janelia-kicad/stepper_driver/documentation/bom/wip.org

| Item | Description                     | Manufacturer Part Number | Manufacturer        |
|------+---------------------------------+--------------------------+---------------------|
|    1 | 1MM FLEX CABLE JUMPER           | FJ-20-D-12.00-4          | Samtec Inc.         |
|    2 | CONN FFC BOTTOM 20POS 1MM R/A   | ZF1-20-01-T-WT-TR        | Samtec Inc.         |
|    3 | TERM BLOCK PLUG 8POS STR 2.5MM  | 1778890                  | Phoenix Contact     |
|    5 | 1168-TGH-0075-01-ND             | TGH-0075-01              | t-Global Technology |
|      |                                 |                          |                     |
