janelia-kicad/stepper_driver/documentation/schematic/stepper_driver.pdf

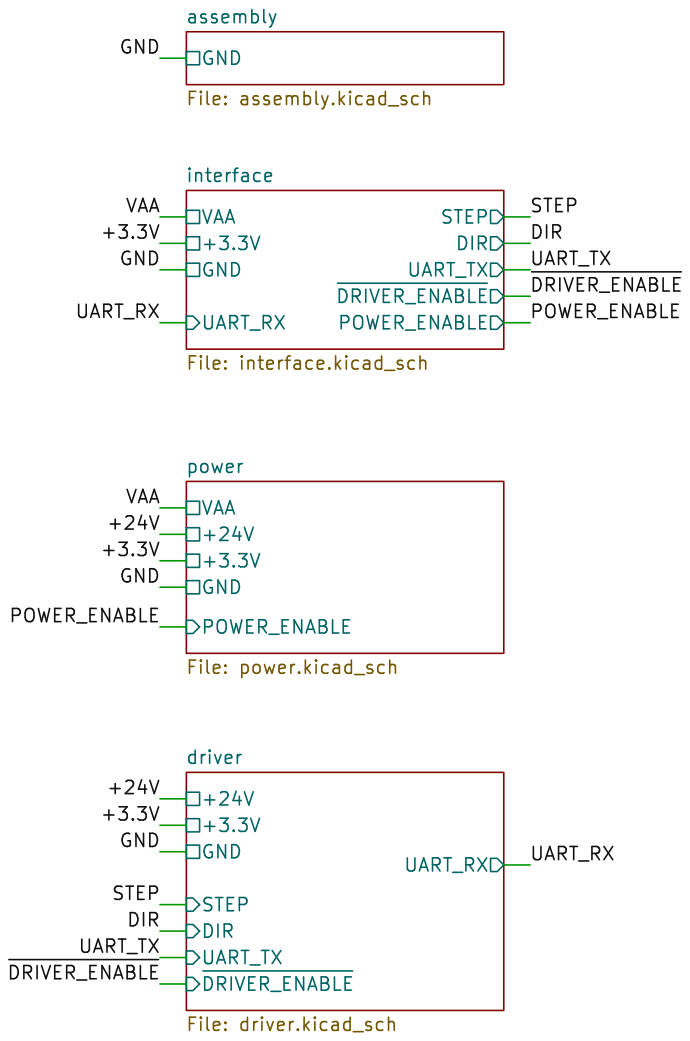
[picture p1: page 1]

assembly File: assembly.kicad_sch DIR
+24V GND GND

interface File: interface.kicad_sch GND

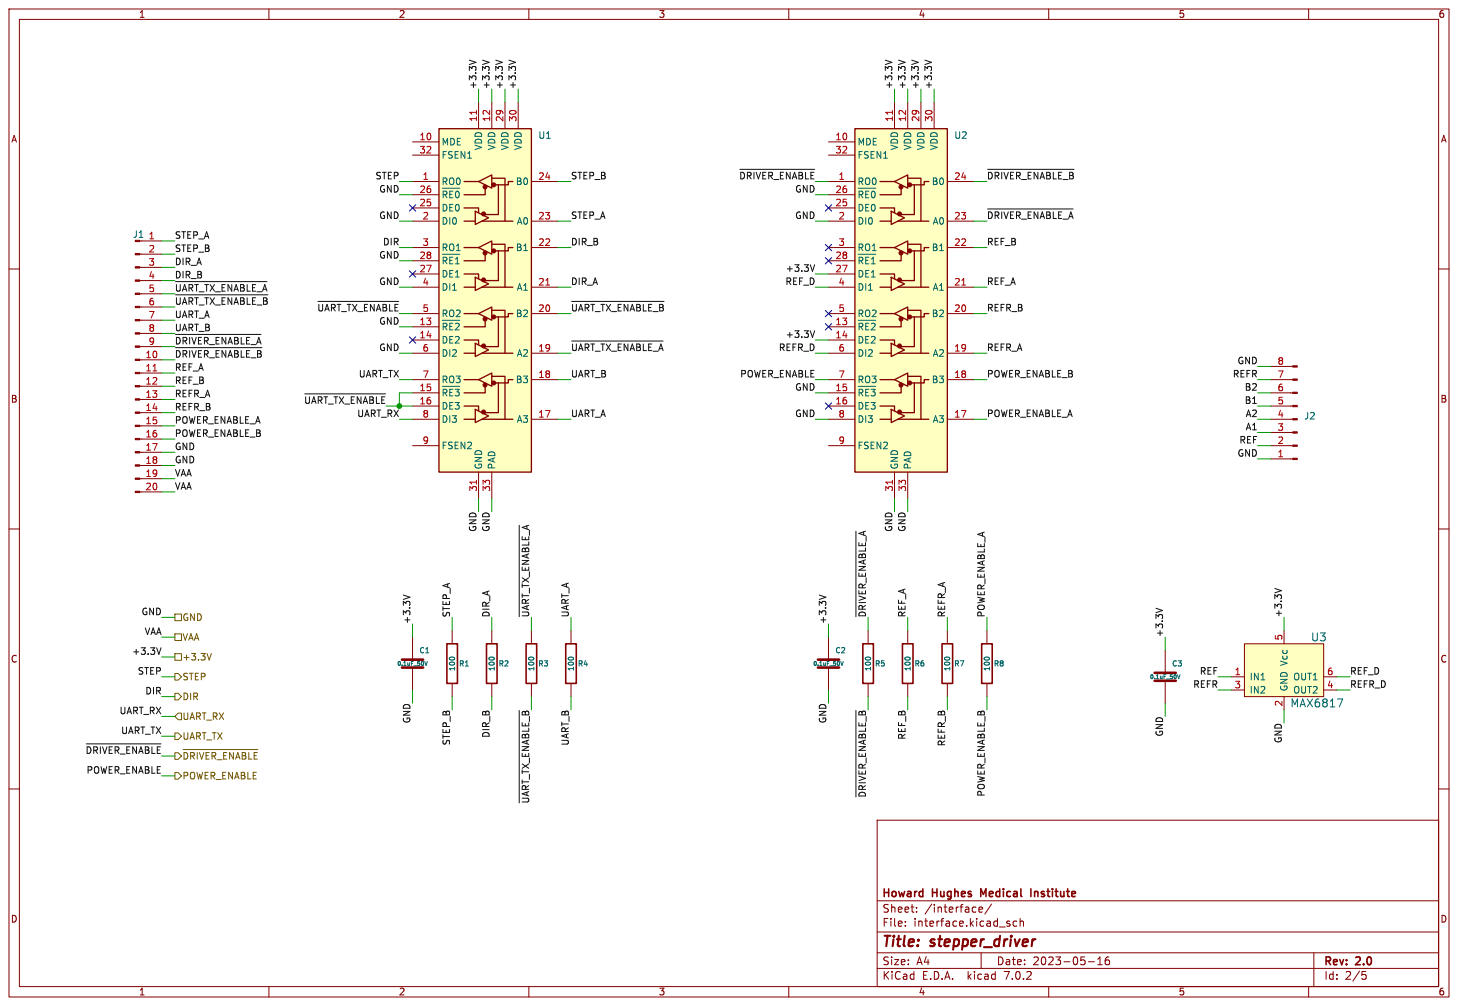
[picture p2: page 2]

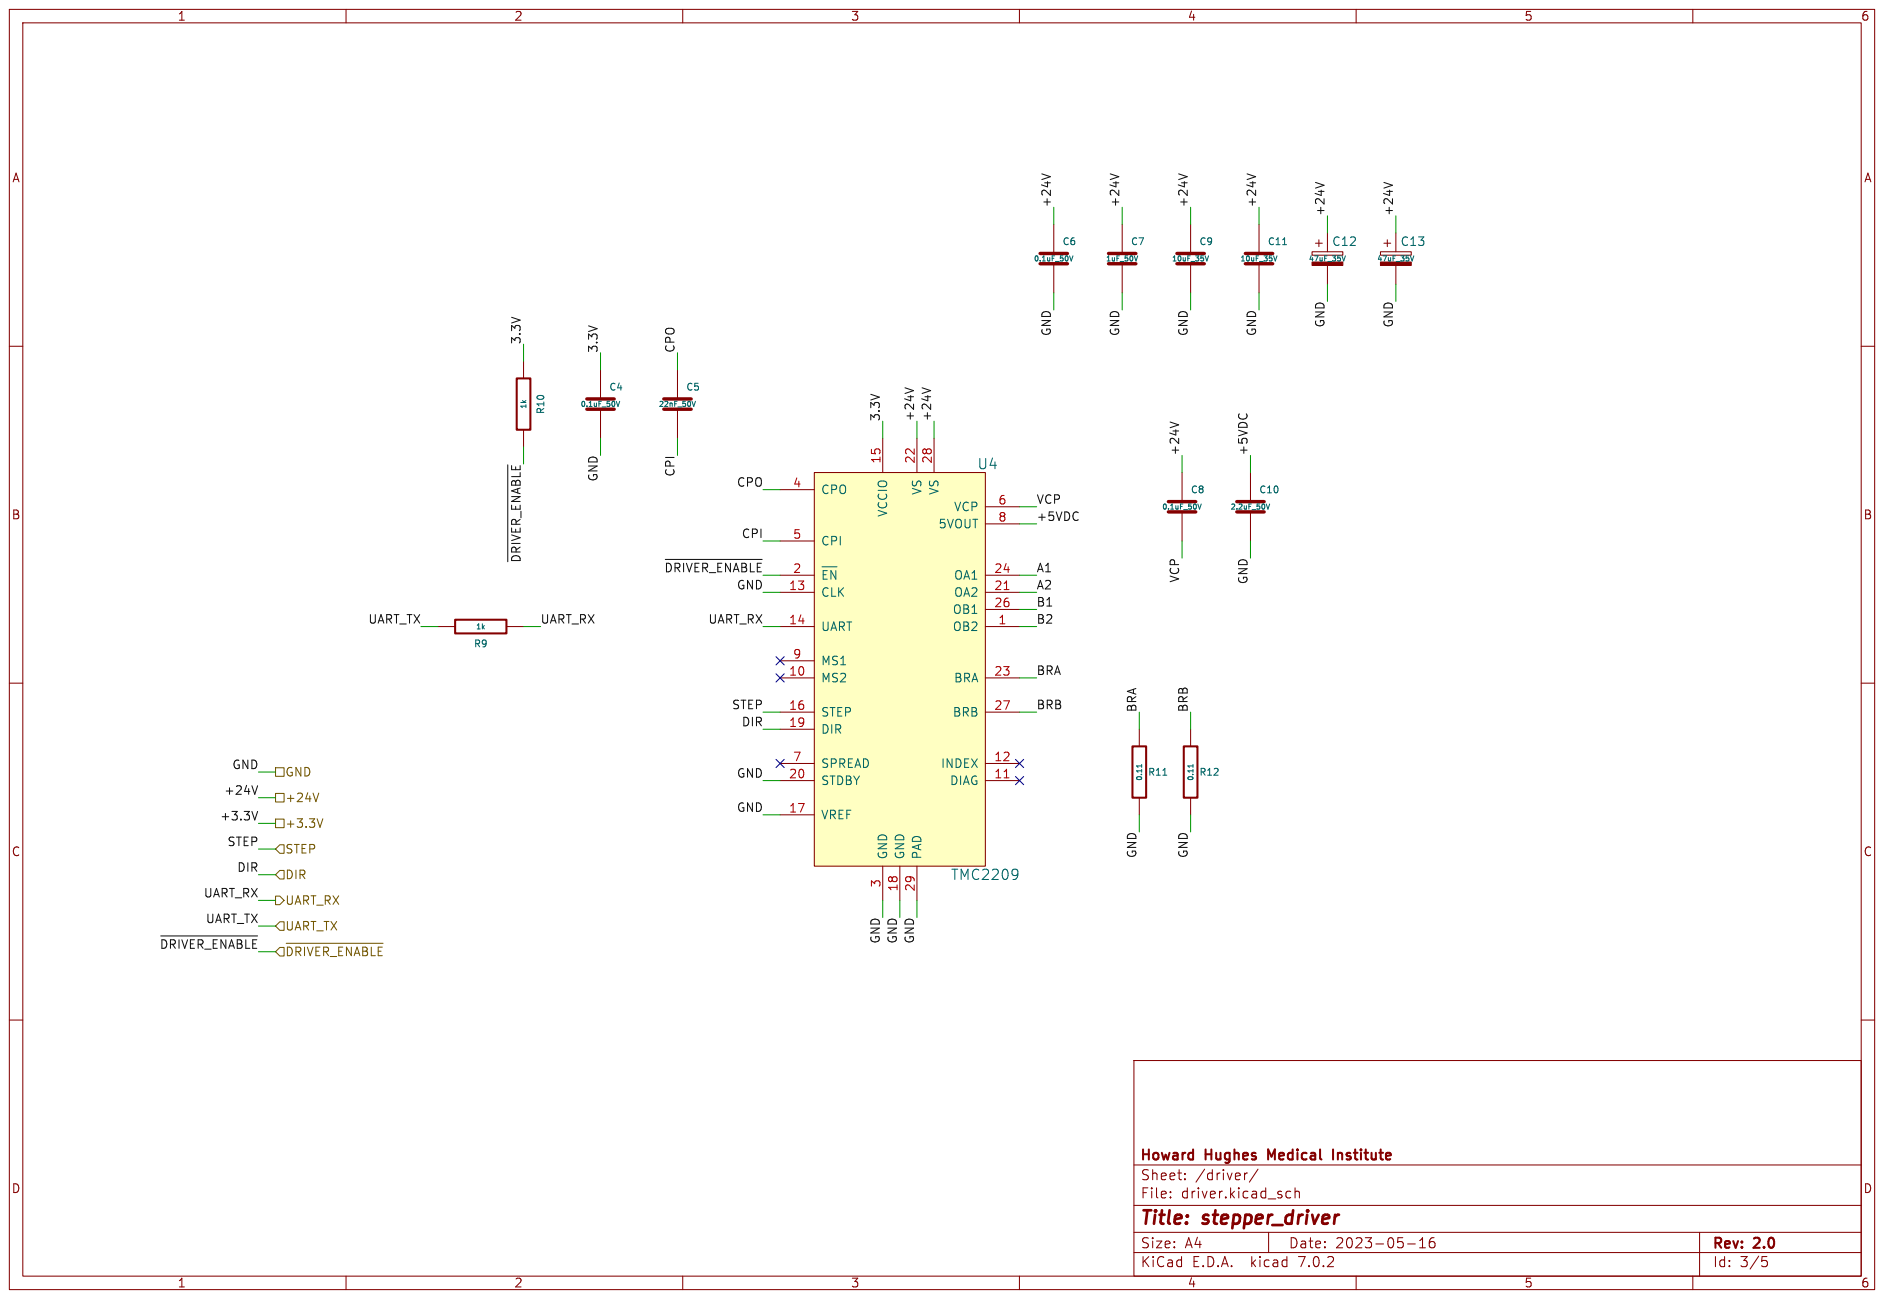
[picture p3: page 3]

3 CPO 4 CPI 5 VCP 6 SPREAD 7

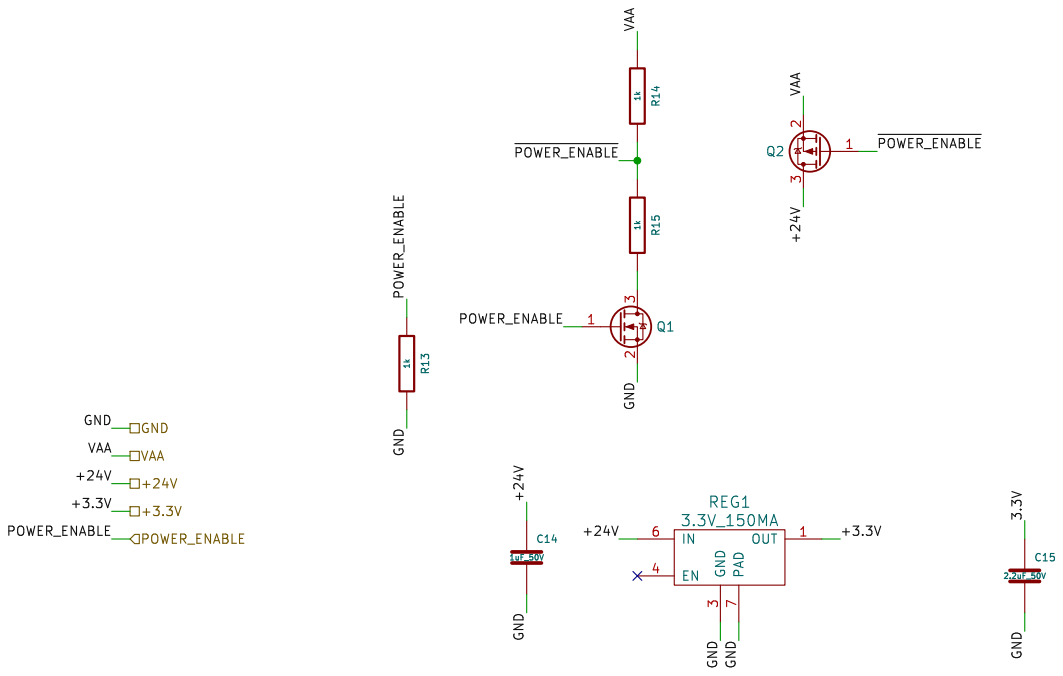
[picture p4: page 4]

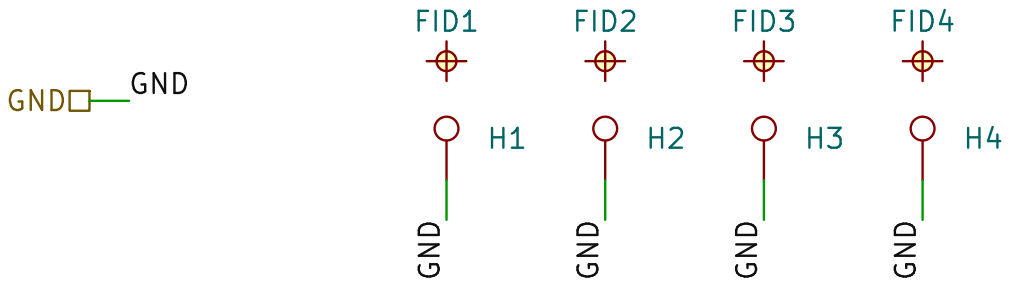
[picture p5: page 5]
