janelia-kicad/stepper_driver/documentation/schematic/stepper_driver-tmc2209.pdf

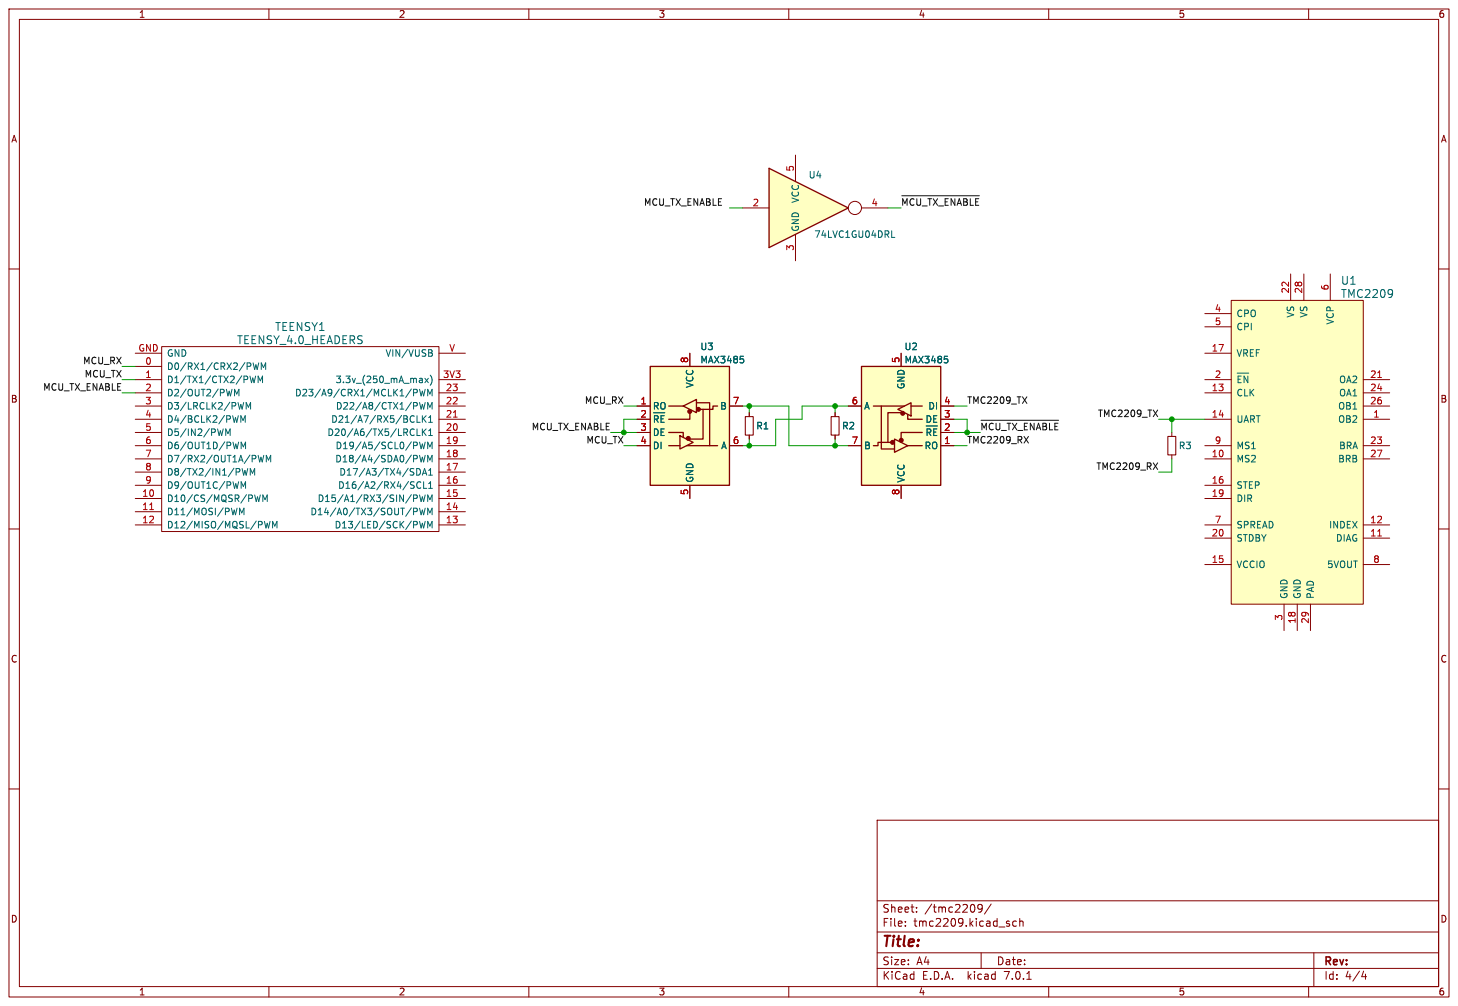
[picture p6: page 1]

8 U2 MAX3485 R1 D0/RX1/CRX2/PWM 0 D1/TX1/CTX2/PWM 1 D10/CS/MQSR/PWM 10 D11/MOSI/PWM 11 D12/MISO/MQSL/PWM 12 D13/LED/SCK/PWM 13 D14/A0/TX3/SOUT/PWM 14 D15/A1/RX3/SIN/PWM 15 D16/A2/RX4/SCL1 16 D17/A3/TX4/SDA1 17 D18/A4/SDA0/PWM 18 D19/A5/SCL0/PWM 19 D2/OUT2/PWM 2 D20/A6/TX5/LRCLK1 20 D21/A7/RX5/BCLK1 21 D22/A8/CTX1/PWM 22 D23/A9/CRX1/MCLK1/PWM 23 D3/LRCLK2/PWM 3

8 U3 MAX3485 RO 1 ~{RE} 2 DE 3 DI 4 GND

Id: 4/4 Title: File: tmc2209.kicad_sch Sheet: /tmc2209/
