janelia-kicad/stepper_driver/(commit log)

2021-10-01 Clear schematic and board
    [stepper_driver.kicad_pcb, stepper_driver.sch]
2021-10-21 Add mounting holes, stepstick, and term block
    [stepper_driver.kicad_pcb, stepper_driver.sch]
2021-10-26 Add connectors
    [stepper_driver.kicad_pcb, stepper_driver.sch]
2021-10-27 Add protection diodes
    [stepper_driver.sch]
2021-10-28 Add power components
    [stepper_driver.kicad_pcb, stepper_driver.sch]
2021-10-29 Add latched header
    [stepper_driver.kicad_pcb, stepper_driver.sch]
2021-11-01 Prepare for routing
    [stepper_driver.kicad_pcb]
2021-11-02 Initial routing
    [stepper_driver.kicad_pcb]
2021-11-03 Finish v1.0 layout
    [stepper_driver-B_Cu.gbl, stepper_driver-B_Mask.gbs, stepper_driver-B_Paste.gbp, stepper_driver-B_SilkS.gbo, stepper_driver-Dwgs_User.gbr, stepper_driver-F_Cu.gtl, stepper_driver-F_Mask.gts, stepper_driver-F_Paste.gtp]
2021-11-03 Update documentation
    [Digi-Key_parts.csv, Mouser_parts.csv, bom.csv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]
2021-11-05 Update supplemental bom
2021-11-15 Add pos file
    [stepper_driver-all-pos.csv]
2021-12-06 Updated supplemental bom
    [supplemental_Digi-Key_parts.csv]
2021-12-07 Add Digi-Key_order
    [Digi-Key_order.csv]
2022-01-27 Add board modifications
2022-01-27 board modifications
    [stepper_driver.kicad_pcb]
2023-03-30 Initial files
    [assembly.kicad_sch, stepper_driver.kicad_pcb, stepper_driver.kicad_sch]
2023-03-31 Initial 2.0 schematic layout
    [assembly.kicad_sch, stepper_driver.kicad_pcb, stepper_driver.kicad_sch]
2023-04-04 Add some parts
    [assembly.kicad_sch, connectors.kicad_sch, stepper_driver.kicad_pcb, stepper_driver.kicad_sch]
2023-04-06 Remove dsub
    [assembly.kicad_sch, connectors.kicad_sch, stepper_driver.kicad_pcb, stepper_driver.kicad_sch]
2023-04-06 Add FFC connector
    [connectors.kicad_sch, driver.kicad_sch, stepper_driver.kicad_pcb, stepper_driver.kicad_sch]
2023-04-06 Place terminal block
    [driver.kicad_sch, stepper_driver.kicad_pcb]
2023-04-07 Increase board size to fit connector
    [stepper_driver.kicad_pcb]
2023-04-13 Place everything on one schematic
    [assembly.kicad_sch, driver.kicad_sch, stepper_driver.kicad_pcb, stepper_driver.kicad_sch]
2023-04-13 Add switch debounce IC
    [stepper_driver.kicad_pcb, stepper_driver.kicad_sch]
2023-04-14 Add reg and capacitors
    [stepper_driver.kicad_pcb, stepper_driver.kicad_sch]
2023-05-01 Update channels
    [stepper_driver.kicad_sch]
2023-05-02 Add transcievers
    [stepper_driver.kicad_pcb, stepper_driver.kicad_sch]
2023-05-03 Add sheets
    [assembly.kicad_sch, driver.kicad_sch, interface.kicad_sch, power.kicad_sch, stepper_driver.kicad_pcb, stepper_driver.kicad_sch]
2023-05-04 Add power enable circuitry
    [assembly.kicad_sch, driver.kicad_sch, interface.kicad_sch, power.kicad_sch, stepper_driver.kicad_pcb, stepper_driver.kicad_sch]
2023-05-05 Add parts and rename lines
    [assembly.kicad_sch, driver.kicad_sch, interface.kicad_sch, power.kicad_sch, stepper_driver.kicad_sch]
2023-05-09 Finish adding capacitors
    [assembly.kicad_sch, driver.kicad_sch, interface.kicad_sch, power.kicad_sch, stepper_driver.kicad_pcb, stepper_driver.kicad_sch]
2023-05-11 Change LVDS chips
    [assembly.kicad_sch, driver.kicad_sch, interface.kicad_sch, power.kicad_sch, stepper_driver.kicad_pcb, stepper_driver.kicad_sch]
2023-05-12 Add datasheets
    [interface.kicad_sch]
2023-05-15 Increase connector pitch from 0.5mm to 1mm
    [assembly.kicad_sch, driver.kicad_sch, interface.kicad_sch, power.kicad_sch, stepper_driver.kicad_pcb, stepper_driver.kicad_sch]
2023-05-16 Finished schematic layout
    [assembly.kicad_sch, driver.kicad_sch, interface.kicad_sch, power.kicad_sch, stepper_driver.kicad_pcb, stepper_driver.kicad_sch]
2023-05-16 Rearrange some wiring
    [interface.kicad_sch, stepper_driver.kicad_pcb]
2023-05-18 Minor schematic changes
    [assembly.kicad_sch, driver.kicad_sch, interface.kicad_sch, power.kicad_sch, stepper_driver.kicad_sch]
2023-06-02 Kicad 7.0.2 -> 7.0.5
2023-06-07 power_enable -> standby
    [assembly.kicad_sch, driver.kicad_sch, interface.kicad_sch, power.kicad_sch, stepper_driver.kicad_sch]
2023-06-07 Fix ERC errors
    [assembly.kicad_sch, driver.kicad_sch, interface.kicad_sch, power.kicad_sch, stepper_driver.kicad_pcb]
2023-06-12 Route some traces
    [assembly.kicad_sch, driver.kicad_sch, interface.kicad_sch, power.kicad_sch, stepper_driver.kicad_pcb, stepper_driver.kicad_sch]
2023-07-11 Update kicad from 7.0.5 to 7.0.6
2023-07-12 Move pins
    [assembly.kicad_sch, driver.kicad_sch, interface.kicad_sch, power.kicad_sch, stepper_driver.kicad_pcb, stepper_driver.kicad_sch]
2023-07-13 Shrink board and move flex cable connector
    [stepper_driver.kicad_pcb]
2023-07-13 Change 8 pin connector
    [interface.kicad_sch, stepper_driver.kicad_pcb]
2023-07-13 Change 8 pin connector from surface mount to through hole
    [assembly.kicad_sch, driver.kicad_sch, interface.kicad_sch, power.kicad_sch, stepper_driver.kicad_pcb, stepper_driver.kicad_sch]
2023-07-13 Update wip bom
2023-07-14 Add heatsink
    [assembly.kicad_sch, driver.kicad_sch, interface.kicad_sch, power.kicad_sch, stepper_driver.kicad_pcb, stepper_driver.kicad_sch]
2023-07-14 Fix pcb issues
    [assembly.kicad_sch, stepper_driver.kicad_pcb]
2023-07-17 Update net classes
    [driver.kicad_sch, stepper_driver.kicad_pcb]
2023-07-18 Route more tracks
    [assembly.kicad_sch, driver.kicad_sch, interface.kicad_sch, power.kicad_sch, stepper_driver.kicad_pcb, stepper_driver.kicad_sch]
2023-07-31 Initial placement of tracks and zones
    [assembly.kicad_sch, driver.kicad_sch, interface.kicad_sch, power.kicad_sch, stepper_driver.kicad_pcb, stepper_driver.kicad_sch]
2023-08-03 packages3D -> 3dmodels
    [stepper_driver.kicad_pcb]
2023-08-25 Change project-edits to kicad-edits
2023-10-12 Update kicad to 7.0.8
2023-10-12 Add top silkscreen text
    [assembly.kicad_sch, driver.kicad_sch, interface.kicad_sch, power.kicad_sch, stepper_driver.kicad_pcb, stepper_driver.kicad_sch]
